yazetsepu/Capstone-2022/README.md

# Chamaecrista Sustainability System
## Capstoneers Team

Capstoneers trans

### Members:
- Yazet Sepulveda 
- David Ortiz 
- Michael Alvarado
- Kevin Santiago 

### Description

The Chamaecrista Sustainability System is design by the team Capstoneer from the University of Puerto Rico - Mayagüez Campus with the problem of the *Chamaecrista Glandulosa* var *Mirabilis* which is an endangered endemic plant from Puerto Rico. This plant has a unique environment and researchers from the University of Puerto Rico – Rio Piedras Campus want to grow this plant in a laboratory to study its humidity, temperature, soil moisture and light conditions as well as the circadian rhythm of the plant.

<!--ts-->
   * [Description](#description)
   * [Table of contents](#table-of-contents)
   * [Hardware](#hardware)
	   * [Microcontroller](#microcontroller)
	   * [Sensors](#sensors)
	   * [Ethernet and Storage](#ethernet-and-storage) 
	   * [Schematics](#schematics)
		* [Flowchart](#flowchart)
<!--te-->

# Hardware 
## Microcontroller 
The CSS is design with the use of a Arduino Mega 2560 Rev3 to connect multiple sensors, cameras, water pump, water valve, PWM for LEDS and ethernet connection
| microcontroller | 
|:--:| 
| *Arduino Mega 2560* |

## Sensors:
CSS system has Humidity, Temperature, Soil Moisture, Light and Real Time Clock sensors as well as a four (4) 5MP camera observer the plant growth and circadian cycles. 

| Sensor | Device | Quantity |
| --- | --- | --- |
| Humidity & Temperature | DHT22 | 1 |
| Soil Moisture | Capacitive Soil Moisture Sensor v2.0 | 8 |
| Light | BH1750 | 1 |
| Real Time Clock | DS3231 | 1 |
| Camera | Arducam OV5642 5MP Plus | 4 |


| camera| 
|:--:| 
| *Arducam OV5642 Mini 5MP Plus* |
## Ethernet and Storage
In order to connect to server and keep all the data collected locally store the design uses a W5100 Ethernet Shield with a 32GB micro-SD card.
| Capstoneers trans| 
|:--:| 
| *W5100 Ethernet Shield* |

## Schematics
CSS_Mega_schematic

CSS_Mega_bb

# Flowchart
| Arduino FlowChart| 
|:--:| 
| *Flowchart* |
