yazetsepu/Capstone-2022/Arduino/Documentation/CSS_Mega_bb.png

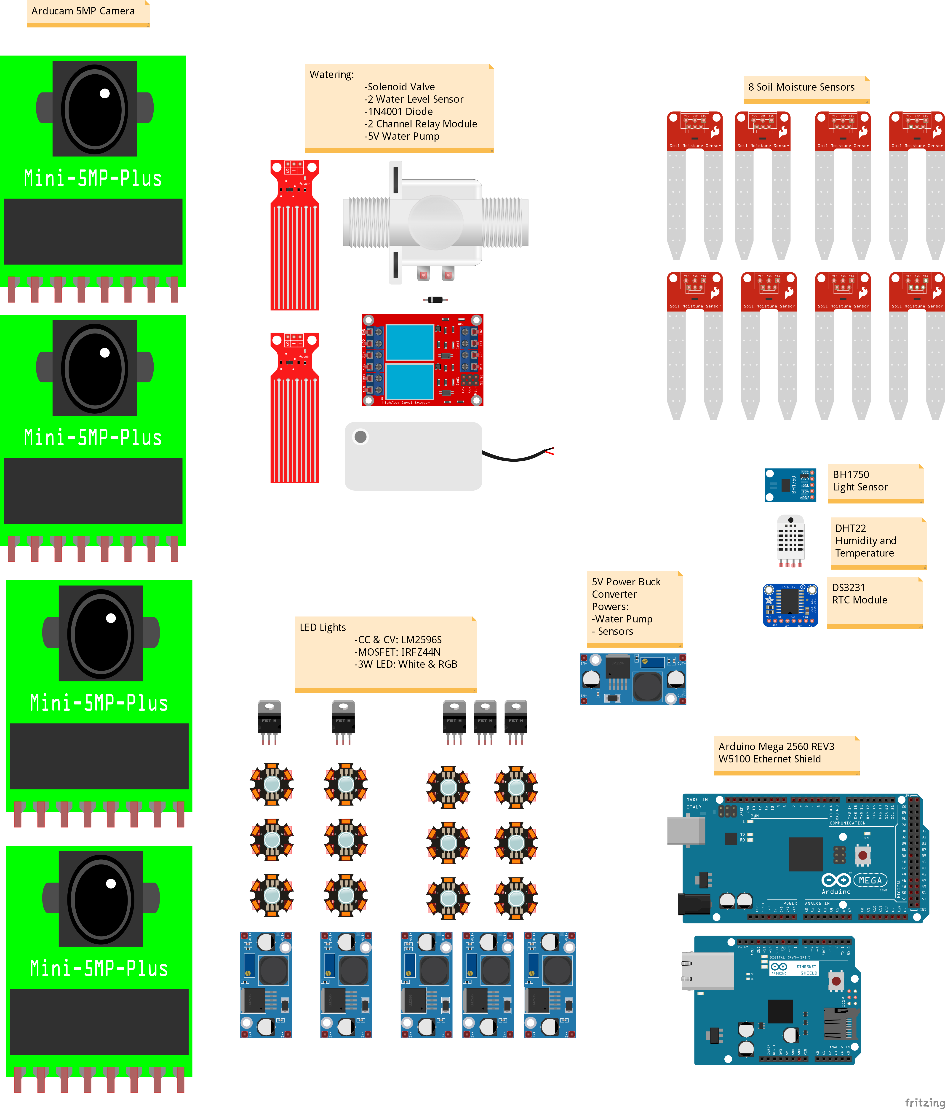
Arduino/Documentation/CSS_Mega_bb.png
