yazetsepu/Capstone-2022/Arduino/Documentation/CSS_Mega_schematic.png

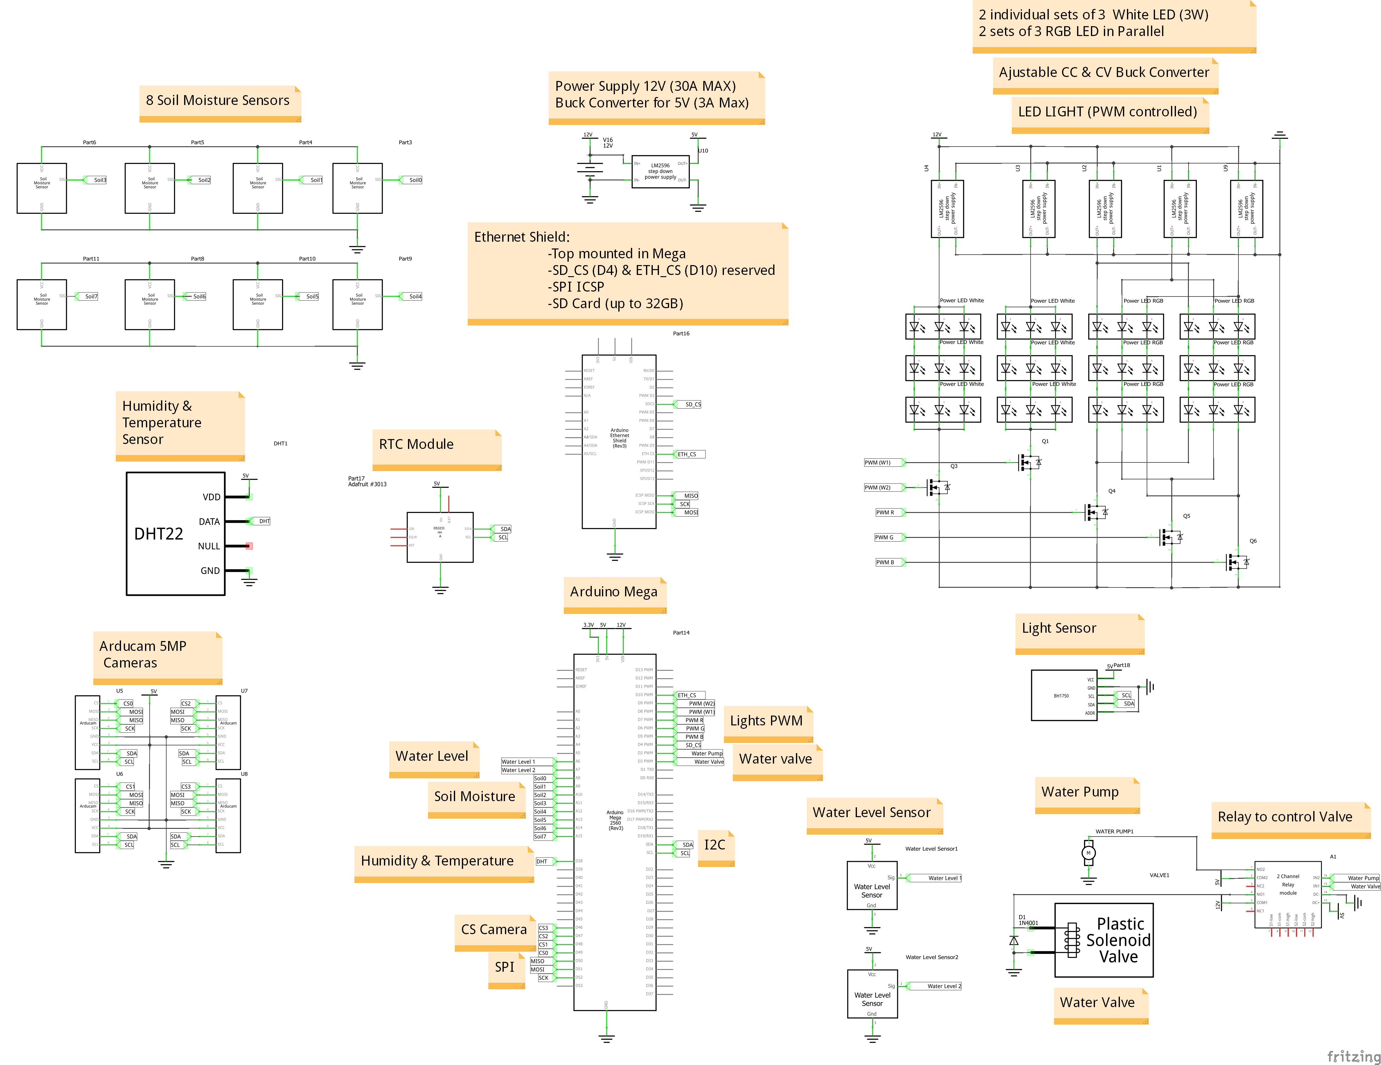
Arduino/Documentation/CSS_Mega_schematic.png
