yazetsepu/Capstone-2022/Arduino/Main/DataManager.h

#ifndef DATA_MANAGER_H
#define DATA_MANAGER_H
#include <Arduino.h>
#include <ArduinoJson.h>


//Digital Pins
#define SD_CS 4     //SD enable pin
#define ETH_CS 10   //Ethernet enable pin
#define Cam_1_CS 48 //Arducam 1 enable pin

//Setup 
bool setupSD();
void initializeEthernet();
//TCP Server
void sendImageTCP(String imagePath, int cam);
void JSONSend();
int EndCapture();
//Web Server (Back-End)
void JSONSendHttp(int pic_Id);
int CommandGetHttp(String *command, String *value);
void CommandPerformedHttp(String log);
//Serial
void sendDataFile();
void sendLastPicture();
bool sendFile(String path);
//SD save
void saveLog(int code, String name, int severity, String message); 
void saveDataToSD(String data[], int sizeData);
//File To Server
void flagData();
void flagImage(String path);
//File Addresses
String getImageFolder(); //Return Image Folder (To save Images)
String getLightScheduleAddress(); //Return the Address to the Light Schedule File 
String getCalibrationAddress();   //Get Soil Moisture Calibration Settings
void infoSD(); //To Serial

#endif
