yazetsepu/Capstone-2022/(commit log)

2022-10-20 Arduino Software commit
    Has Arducam save picture, capture temp, humidity, moisture and light. Sends Serial.
2022-10-22 Arduino Software Refactor and documentation
2022-10-24 Light Schedule and Camera refactor (4 cams)
2022-10-25 Update Arduino_Uno_Test.ino
    soil moisture and water pump test
2022-10-31 Flag Files and TCP server Stability
    [Cameras.cpp, DataManager.cpp, DataManager.h, LightSystem.cpp, LightSystem.h, Main.ino, Sensors.cpp]
2022-12-08 Integration fix (Water, Sensor and Camera)
    Fix Water System Parameters, and Camera enable redundancy
    [Cameras.cpp, DataManager.cpp, LightSystem.cpp, Main.ino, Sensors.cpp, WaterSystem.cpp]
